TDS-OYM/rajikon/無線式ラジコン外観写真.docx

コントローラー

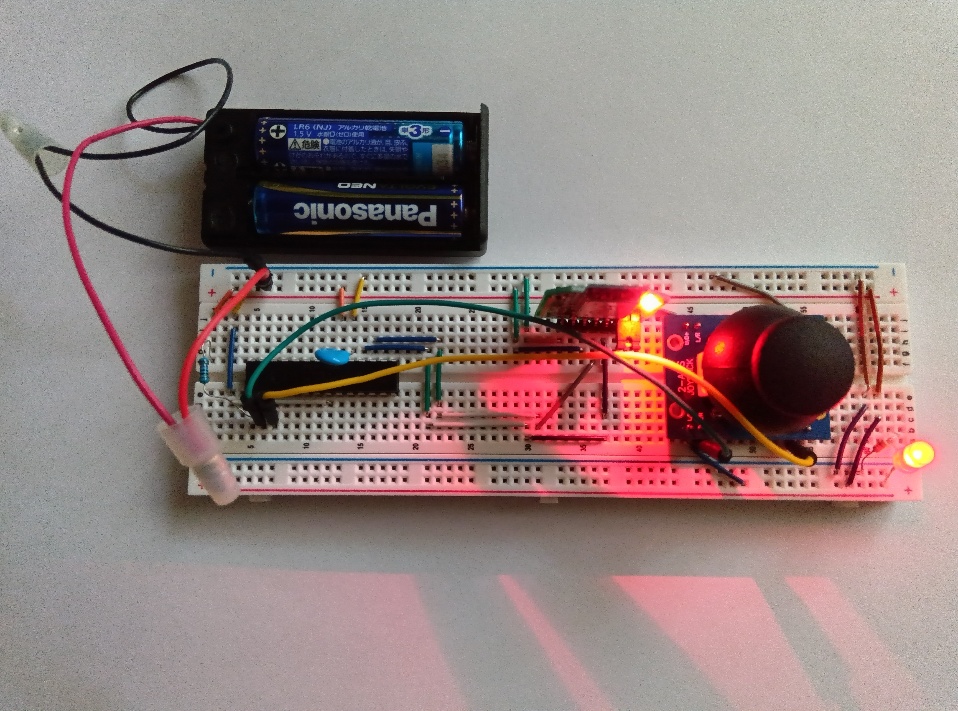
[picture p1: figure]

本体

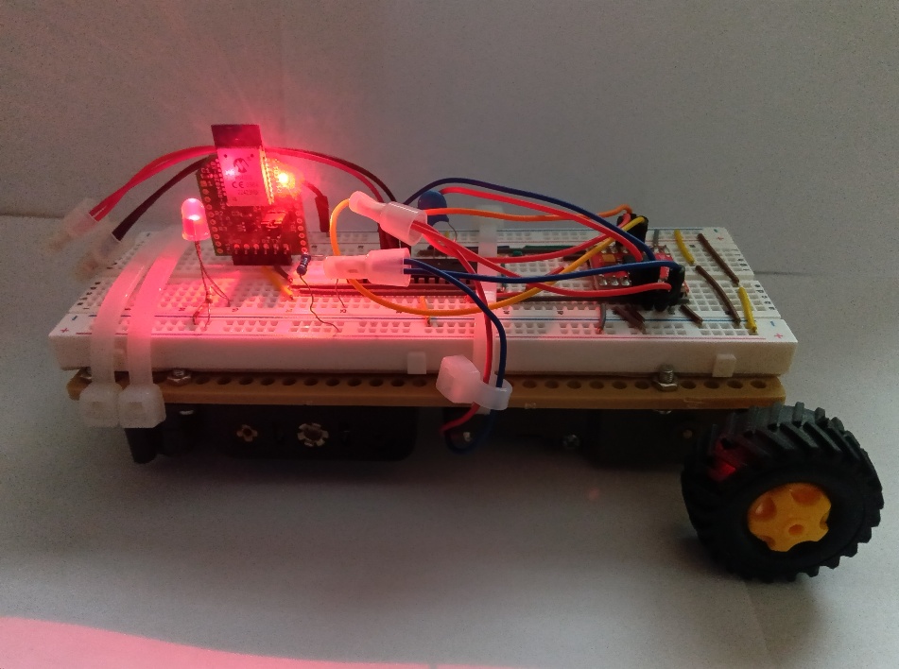
[picture p2: figure]
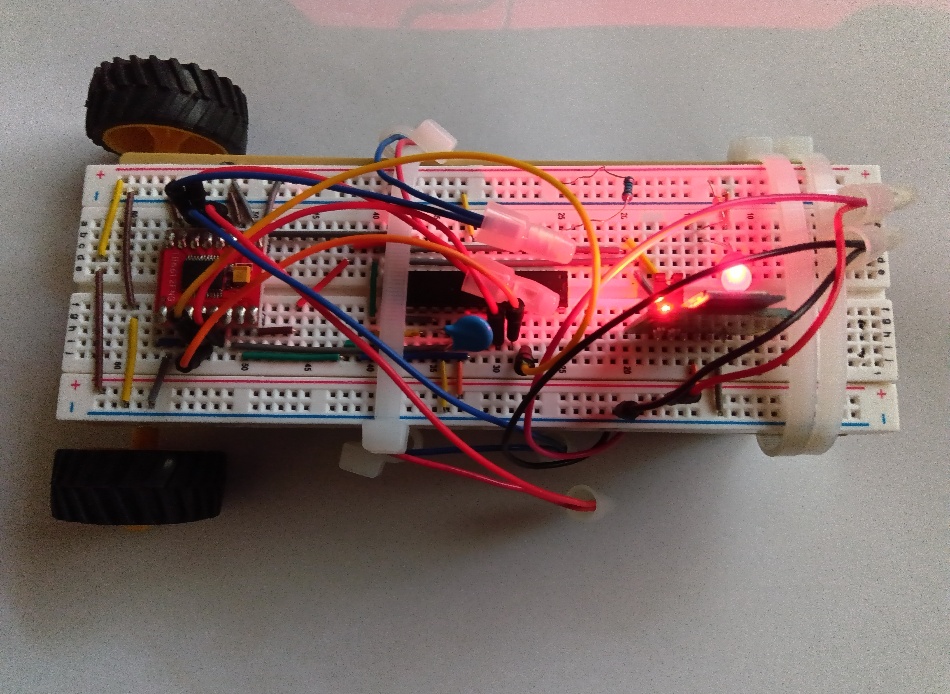
[picture p3: figure]
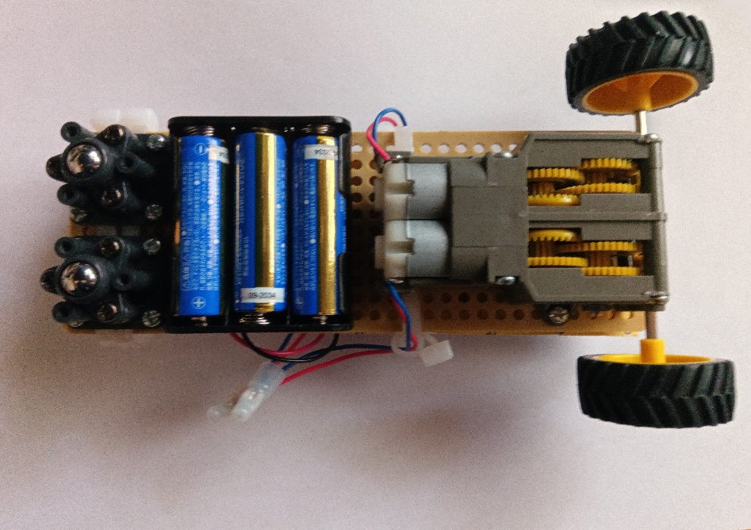
[picture p4: figure]
