TDS-OYM/rajikon/無線式ラジコン電気回路図.docx

無線式ラジコン　電気回路図

1枚目・ラジコン本体

2枚目・コントローラー

作成したKiCadのファイルも

同封しています。

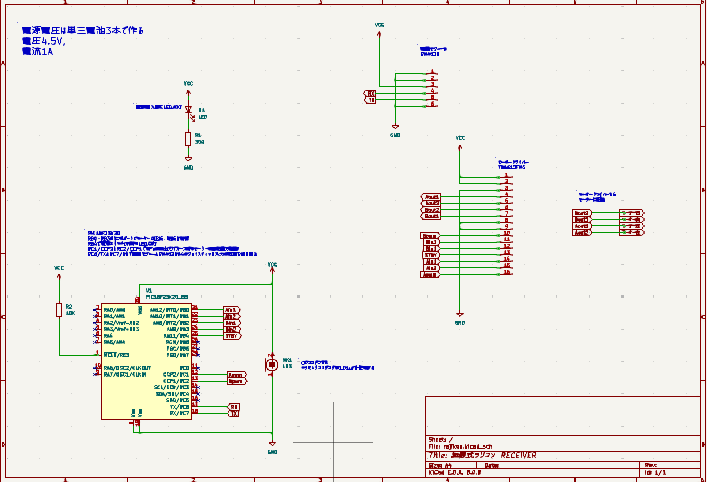
[picture p5: figure]
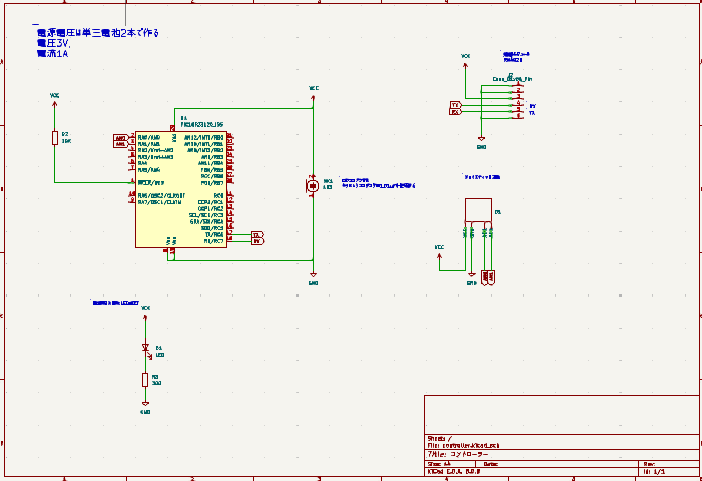
[picture p6: figure]
