TDS-OYM/rajikon/controller.kicad_sch

## KiCad design controller.kicad_sch (2025-04-26)

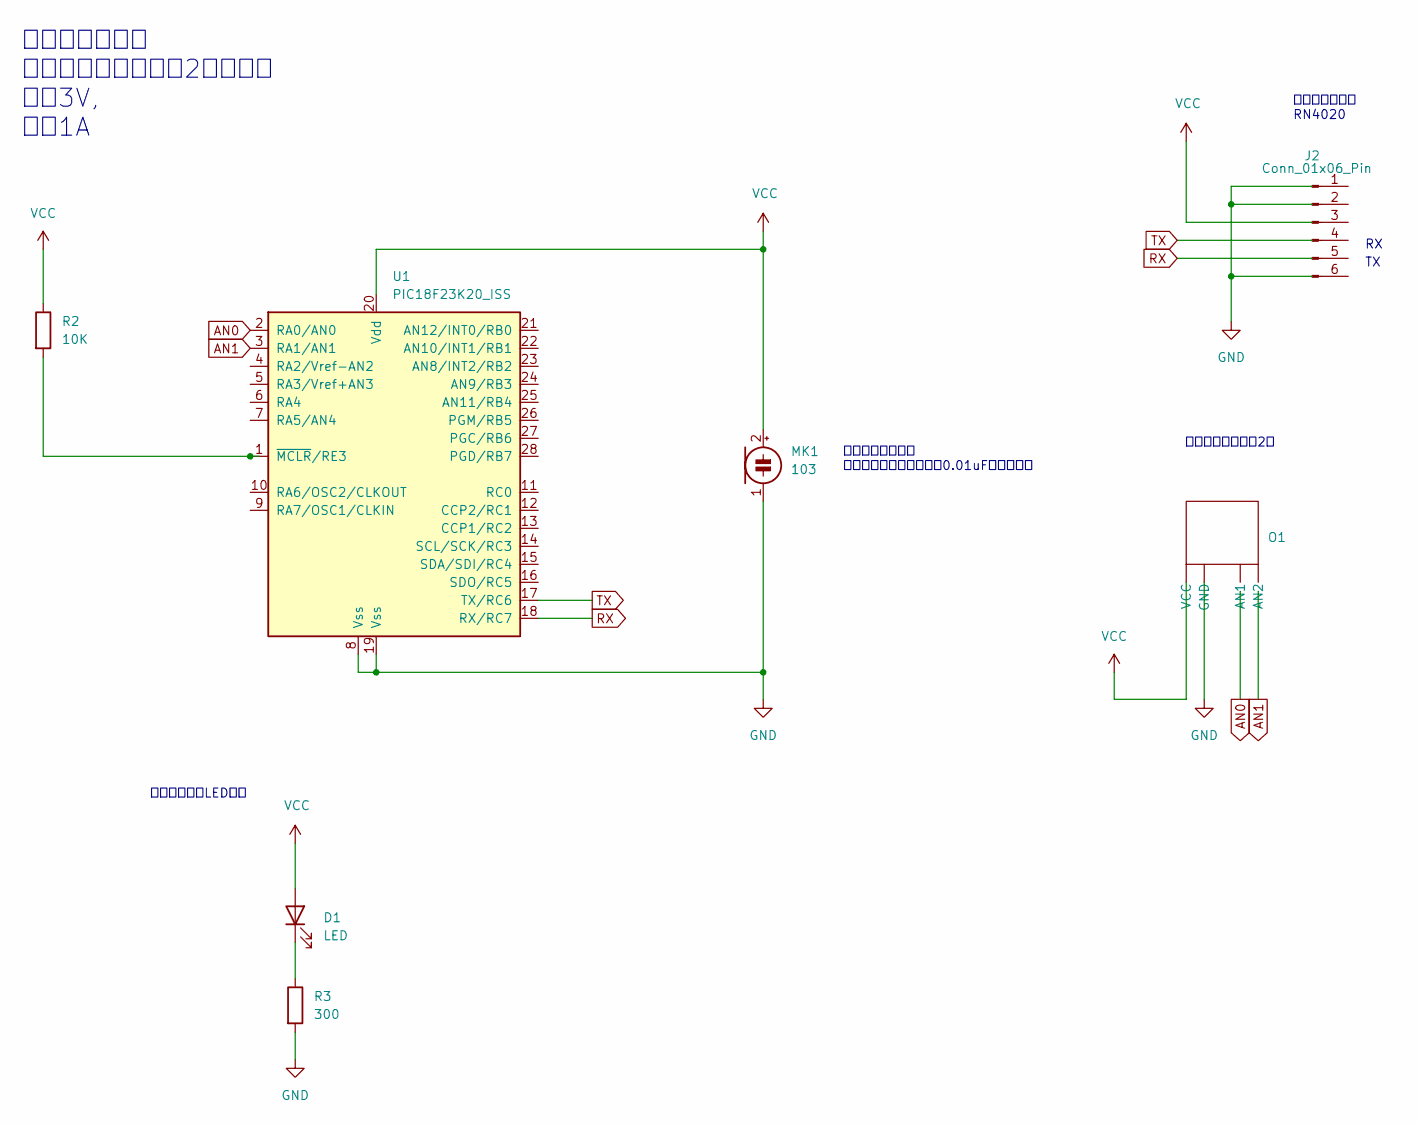
[picture p7: schematic controller.kicad_sch]

Parts:
D1: LED
J2: Conn_01x06_Pin
MK1: 103
O1: (no value)
R2: 10K
R3: 300
U1: PIC18F23K20_ISS; SSOP-28_5.3x10.2mm_P0.65mm

Connections:
AN0: U1.2 (RA0/AN0)
AN1: U1.3 (RA1/AN1)
GND: MK1.1 (-), R3.2, U1.8 (Vss), U1.19 (Vss)
unnamed: D1.1 (K), R3.1
unnamed: R2.2, U1.1 (~MCLR/RE3)
RX: U1.18 (RX/RC7)
TX: U1.17 (TX/RC6)
VCC: D1.2 (A), MK1.2 (+), R2.1, U1.20 (Vdd)

Notes on the sheet:
ジョイスティック2軸
電源投入時にLED点灯
このコンデンサは セラミックコンデンサの0.01uFを使用する
コントローラー 電源電圧は単三電池2本で作る 電圧3V, 電流1A
無線モジュール RN4020
