TDS-OYM/rajikon/rajikon.kicad_sch

## KiCad design rajikon.kicad_sch (2025-04-26)

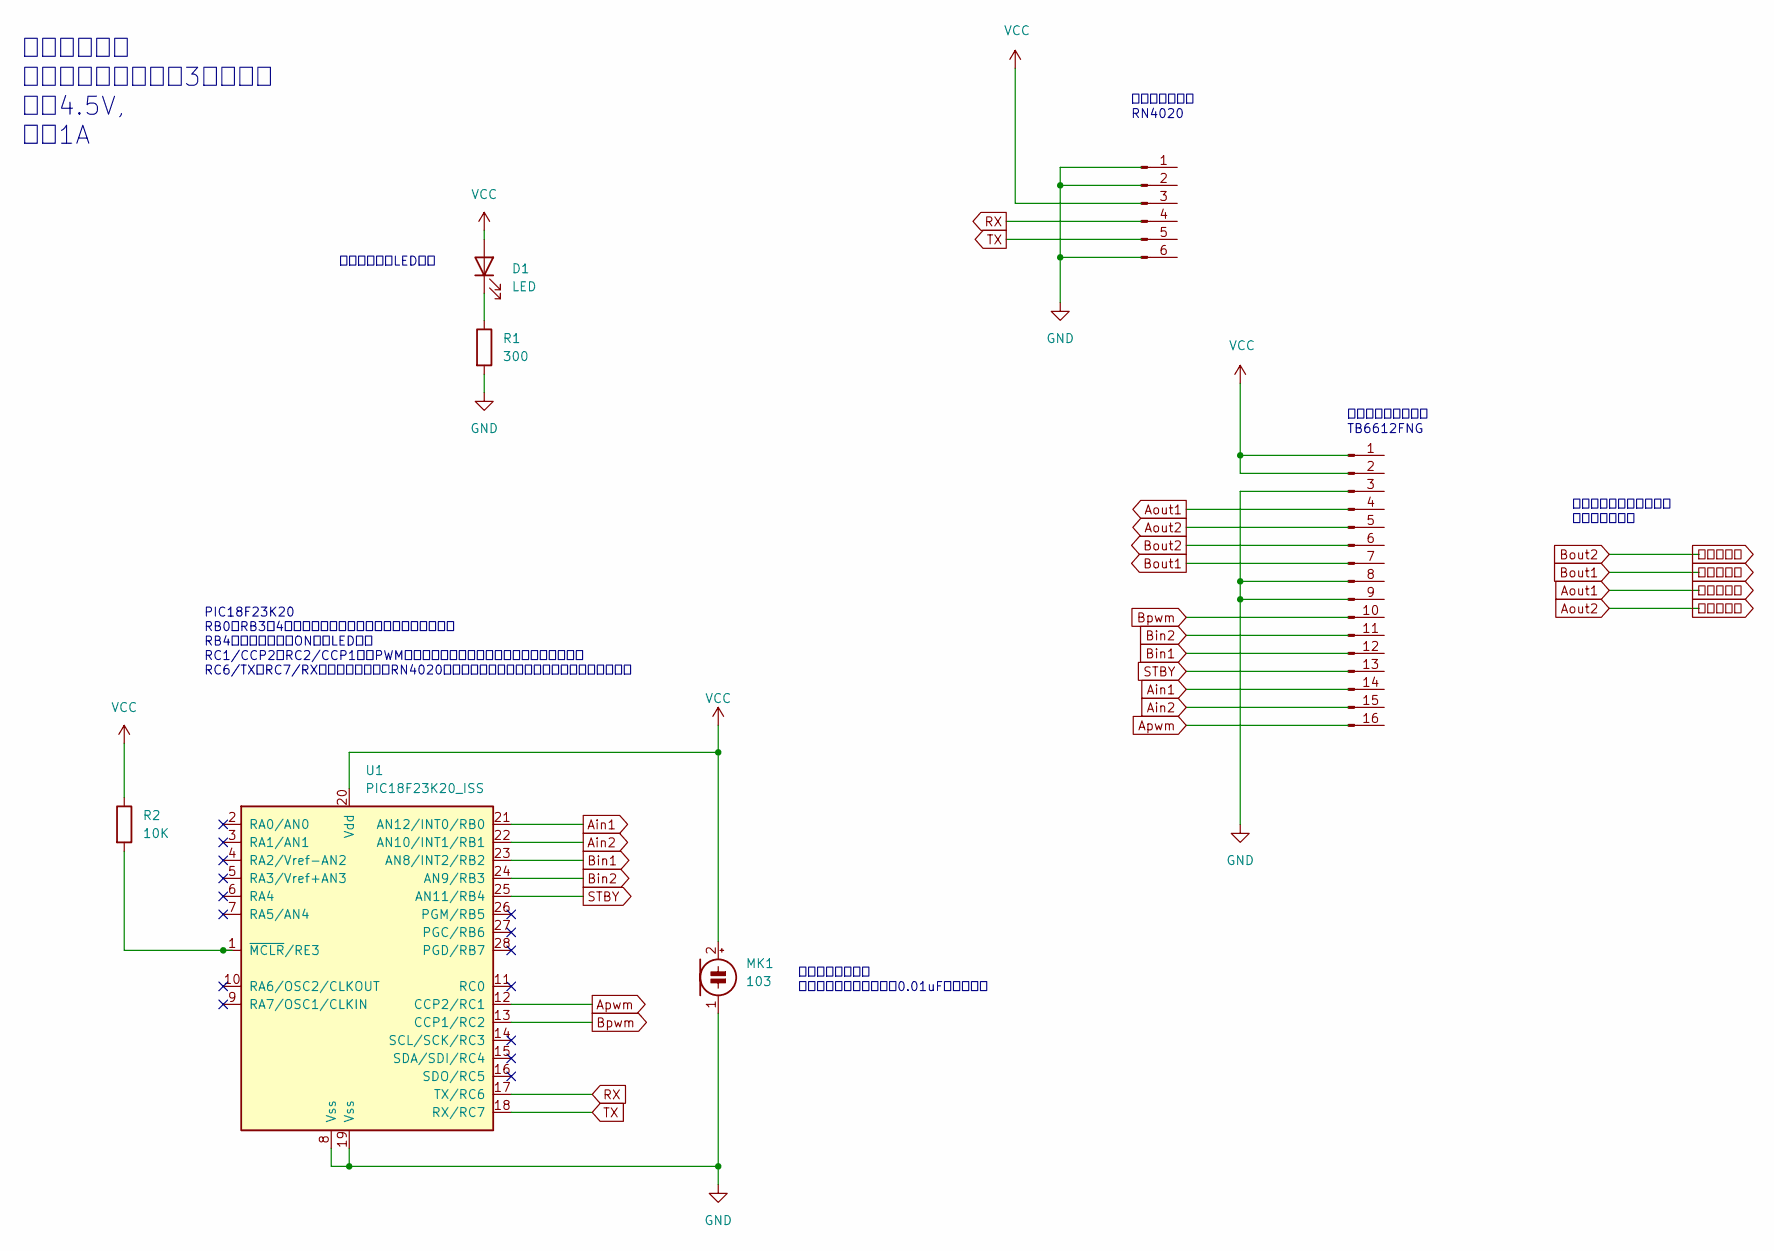
[picture p8: schematic rajikon.kicad_sch]

Parts:
D1: LED
J1: Conn_01x16_Pin
J5: Conn_01x06_Pin
MK1: 103
R1: 300
R2: 10K
U1: PIC18F23K20_ISS; SSOP-28_5.3x10.2mm_P0.65mm

Connections:
Ain1: U1.21 (AN12/INT0/RB0)
Ain2: U1.22 (AN10/INT1/RB1)
Apwm: U1.12 (CCP2/RC1)
Bin1: U1.23 (AN8/INT2/RB2)
Bin2: U1.24 (AN9/RB3)
Bpwm: U1.13 (CCP1/RC2)
GND: MK1.1 (-), R1.2, U1.8 (Vss), U1.19 (Vss)
unnamed: D1.1 (K), R1.1
unnamed: R2.2, U1.1 (~MCLR/RE3)
RX: U1.17 (TX/RC6)
STBY: U1.25 (AN11/RB4)
TX: U1.18 (RX/RC7)
VCC: D1.2 (A), MK1.2 (+), R2.1, U1.20 (Vdd)

Notes on the sheet:
このコンデンサは セラミックコンデンサの0.01uFを使用する
PIC18F23K20 RB0～RB3の4つのポートでモーターの正転、逆転を制御 RB4で電源スイッチON時のLED点灯 RC1/CCP2とRC2/CCP1でのPWMの出力でカーブ時のモーターの回転数の制御 RC6/TXとRC7/RXで無線モジュールRN4020からのジョイスティック入力の数値を受け取る
電源投入時にLED点灯
ラジコン本体 電源電圧は単三電池3本で作る 電圧4.5V, 電流1A
無線モジュール RN4020
モータードライバー TB6612FNG
モータードライバーから モーターに配線
