TDS-OYM/rajikon/(commit log)

2025-04-26 無線式ラジコンの電気回路図
    Kicadで描いた無線式ラジコンの本体、コントローラーの
    電気回路図をWordに張り付けたものです。
2025-04-26 無線式ラジコンの外観写真
    無線式ラジコンの本体、コントローラーの外観写真をWordに張り付けたものです。
2025-04-26 無線式ラジコンの仕様
    無線式ラジコンの仕様や部品の一覧を載せています。
2025-04-26 無線式ラジコンの本体動作プログラム
    無線式ラジコンの本体のプログラムです。
    C言語で記述
    開発環境にMPLAB IDEを使用しています
2025-04-26 無線式ラジコンのコントローラーのプログラム
    無線式ラジコンのコントローラーのプログラムです。
    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
2025-04-26 無線式ラジコンのコントローラーの電気回路図のkicadのファイル
    無線式ラジコンのコントローラーの電気回路図のkicadのファイルです。
    [controller.kicad_sch]
2025-04-26 無線式ラジコンの本体の電気回路図のKicadのファイル
    無線式ラジコンの本体の電気回路図のKicadのファイルです。
    [rajikon.kicad_sch]
2025-04-26 無線式ラジコンのコントローラーの動作プログラム
    無線式ラジコンのコントローラーの動作プログラムです
    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
